LeandroSQ/drybox/pins.md

# Pinout Information

## Arduino Nano

| Color/Type | PIN | Description |
|---|-----|---|
| orange | A0 | thermistor |
| blue | A4 | LCD SDA |
| green | A5 | LCD SDL |
| red | Arduino GND | LCD |
| purple | D3 | LCD POWER |
| yellow | D2 | DHT |
| JST red | Arduino 5v | - |
| JST black | Arduino GND | - |
| Green | Vin | Power supply |
| wine | D10 | Fan |
| black | D11 | Heater |
