LeandroSQ/drybox/(commit log)

2024-04-05 fix: Better DHT freak reading prevention
    [dht.ino]
2024-04-05 refactor: Introduced schematics
2024-04-08 feature: PID Feed forward control using the thermistor readings
2024-04-08 fix: Better fan control for faster warm up
    [fan.ino]
2024-04-08 fix: Calibrated Thermistor
